themiddnight/xpan-film-camera-3d-print/viewer/src/presentation/content/specifications.md

## Specifications

The numbers below are published from the CAD parameters that also drive the model on this page, so they match what you see. A value marked draft is an estimate until a test print confirms it.

{{spec:specs}}
