themiddnight/xpan-film-camera-3d-print/viewer/src/presentation/content/intro.md

## Build it, or design your own

Everything above comes from the same CAD files that make the printable parts. What follows is for people who want to build the camera or design a body or lens for it. Each figure is live: it is the CAD model, restaged.
