themiddnight/xpan-film-camera-3d-print/docs/images/custom-lens-side-40mm-diameter.jpeg

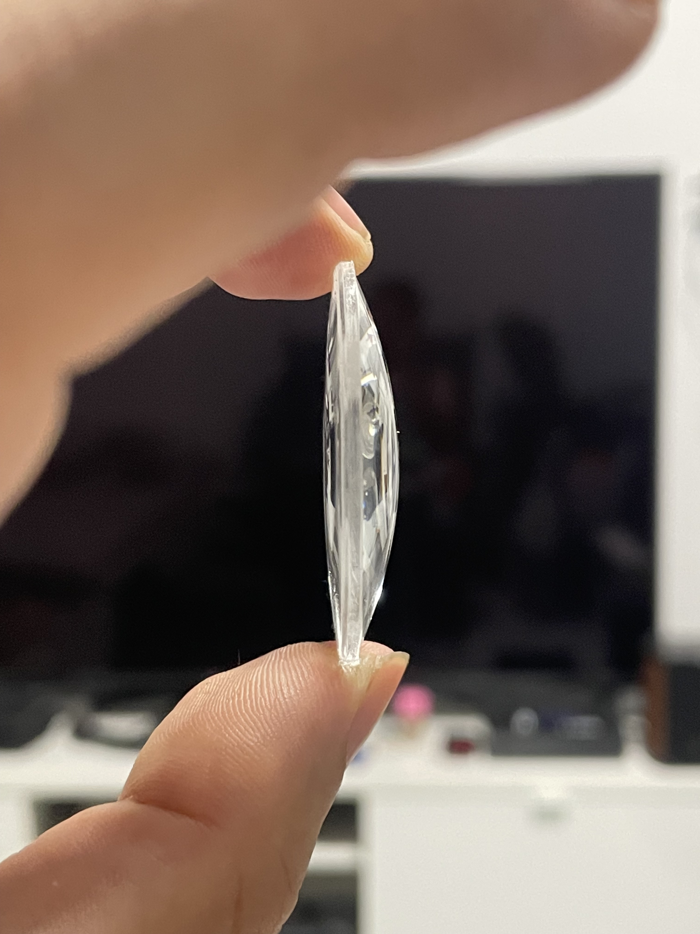
docs/images/custom-lens-side-40mm-diameter.jpeg
