themiddnight/xpan-film-camera-3d-print/docs/images/custom-lens-witn-exist-body.jpeg

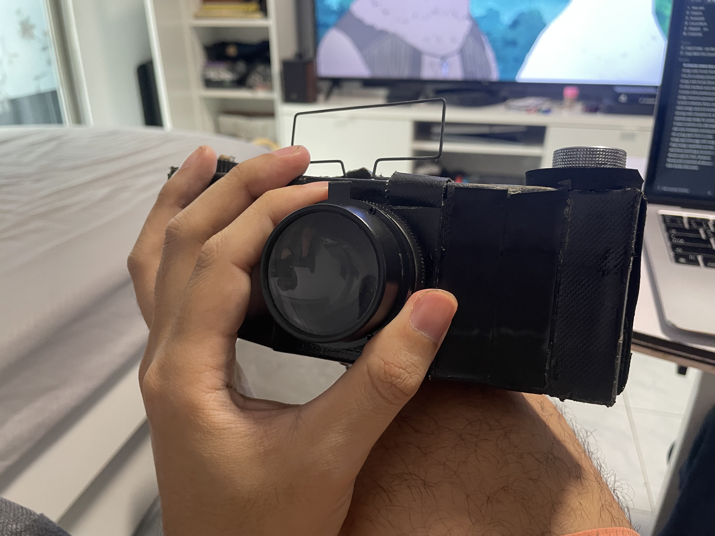
docs/images/custom-lens-witn-exist-body.jpeg
