themiddnight/xpan-film-camera-3d-print/docs/images/example-custom-lens-1.jpeg

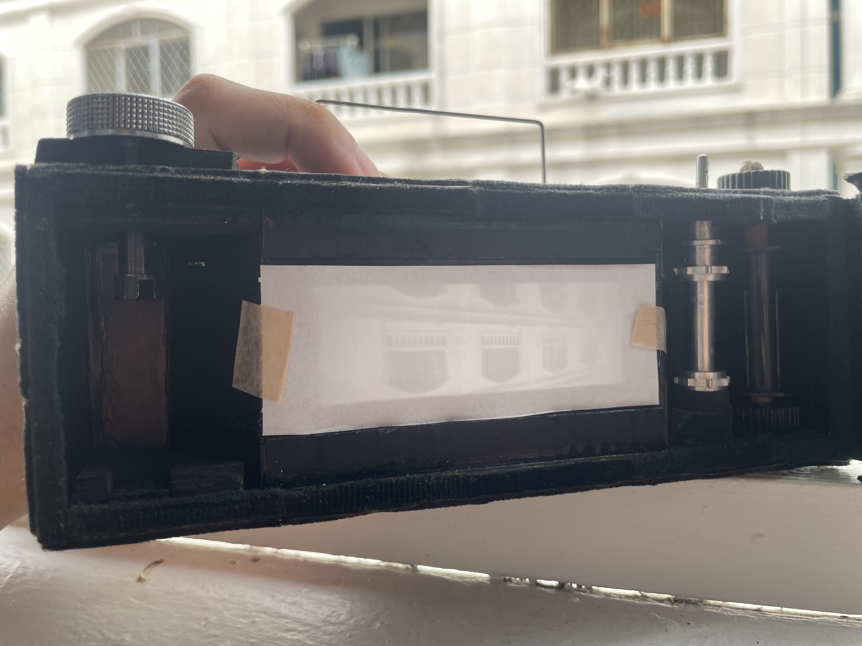
docs/images/example-custom-lens-1.jpeg
