themiddnight/xpan-film-camera-3d-print/docs/images/example-custom-lens-3.jpeg

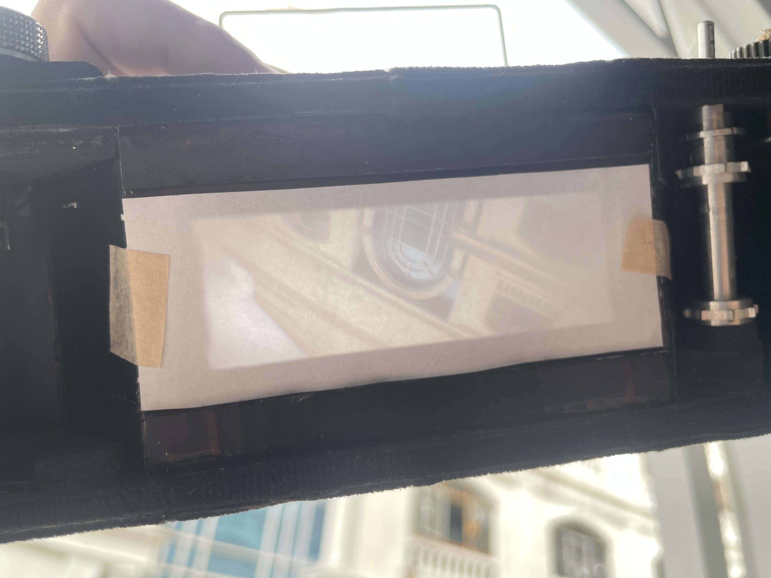
docs/images/example-custom-lens-3.jpeg
