themiddnight/xpan-film-camera-3d-print/docs/images/exist-72x24mm-pinhole-custom-camera-m42.jpeg

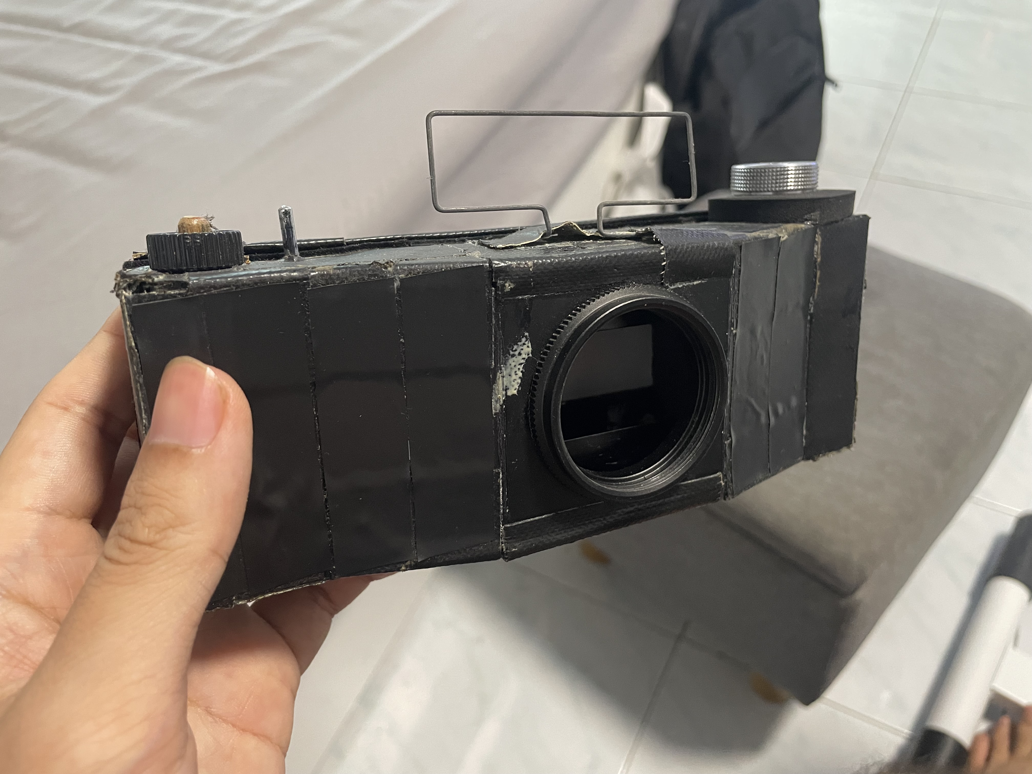
docs/images/exist-72x24mm-pinhole-custom-camera-m42.jpeg
