themiddnight/xpan-film-camera-3d-print/docs/images/exist-m42-pinhole.jpeg

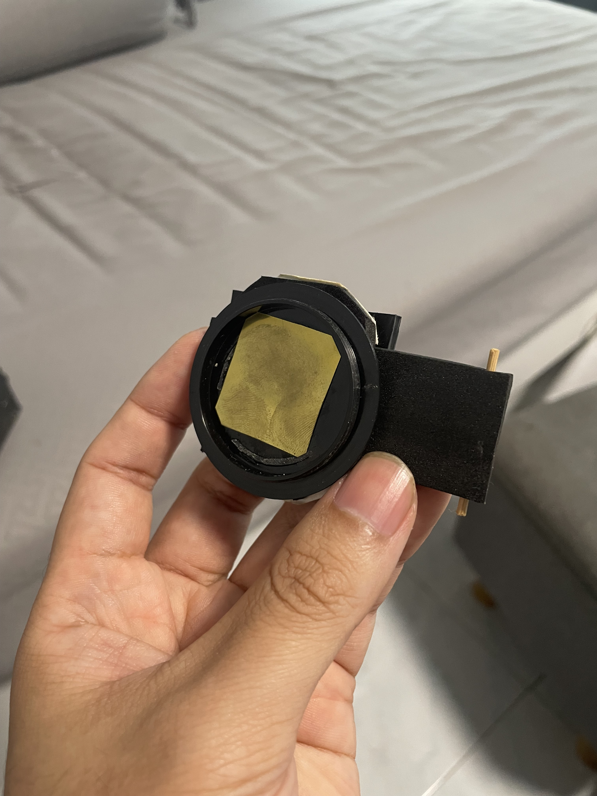
docs/images/exist-m42-pinhole.jpeg
