themiddnight/xpan-film-camera-3d-print/docs/images/proto-film-back-rough-design.png

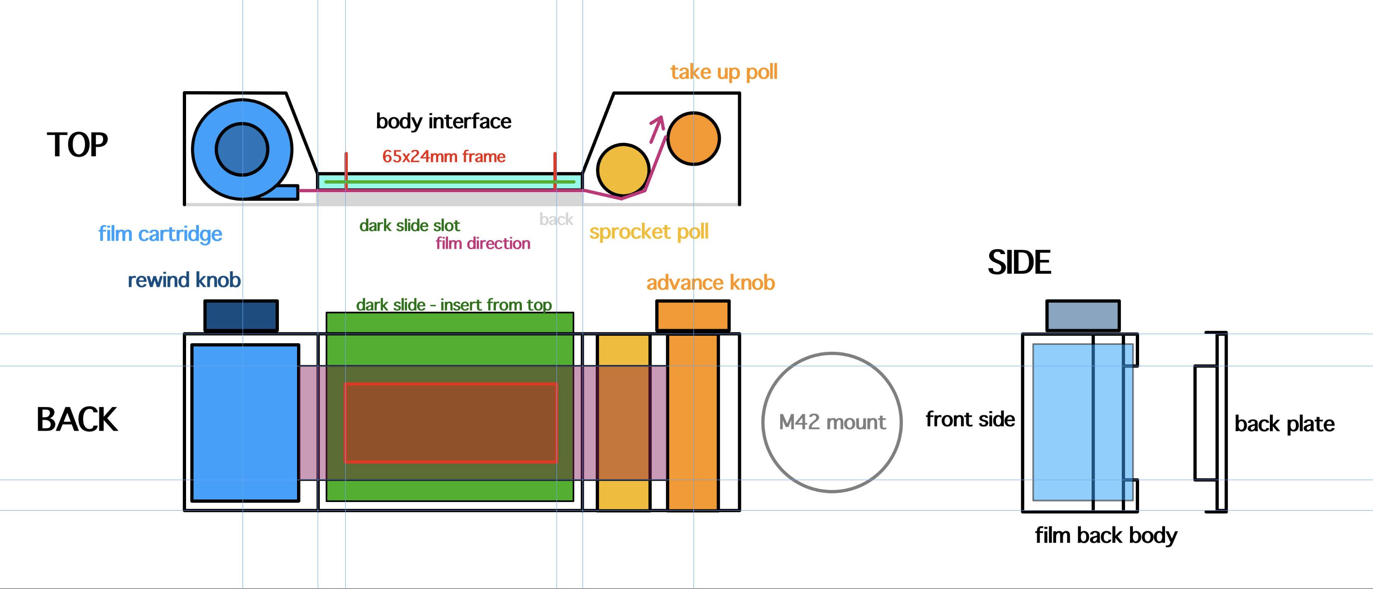
docs/images/proto-film-back-rough-design.png
