themiddnight/xpan-film-camera-3d-print/out/stills/advance.png

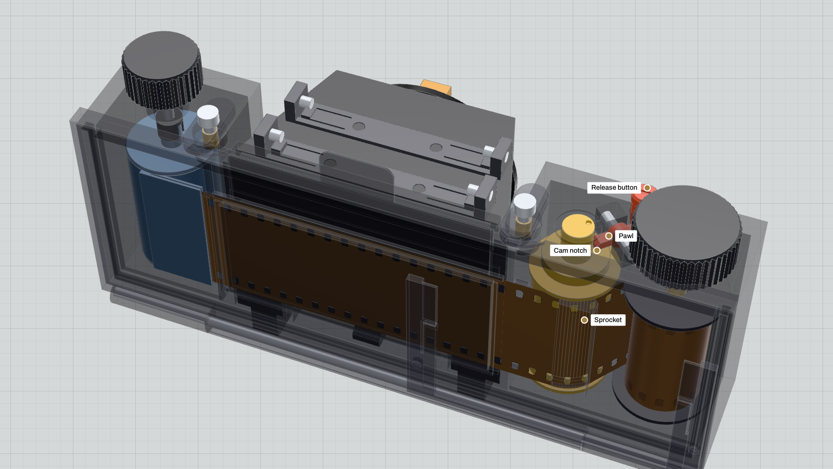
out/stills/advance.png
