themiddnight/xpan-film-camera-3d-print/out/stills/dark-slide.png

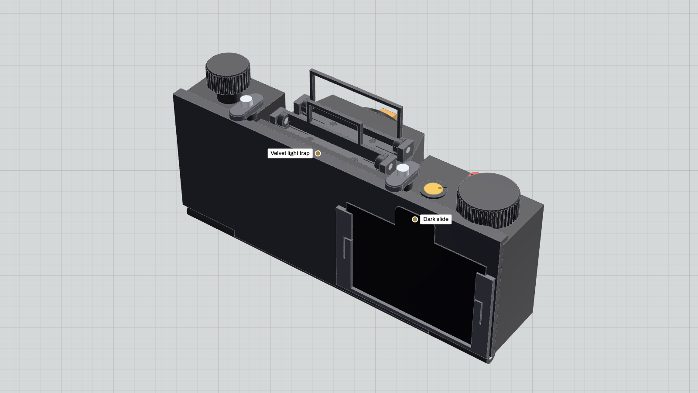
out/stills/dark-slide.png
