themiddnight/xpan-film-camera-3d-print/out/stills/format.png

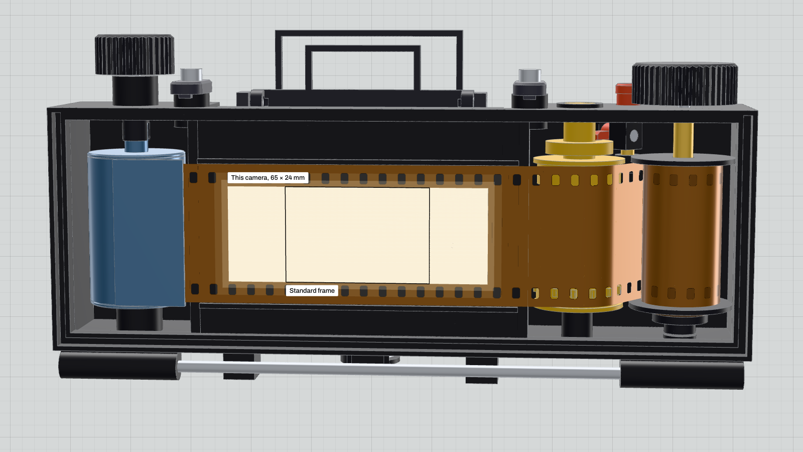
out/stills/format.png
