themiddnight/xpan-film-camera-3d-print/out/stills/loading.png

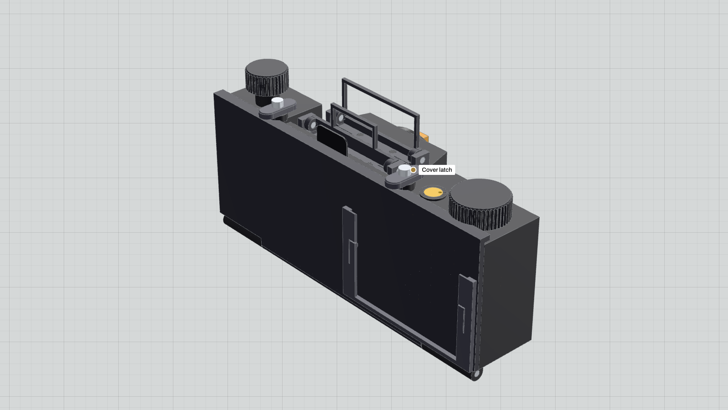
out/stills/loading.png
