themiddnight/xpan-film-camera-3d-print/out/stills/modules.png

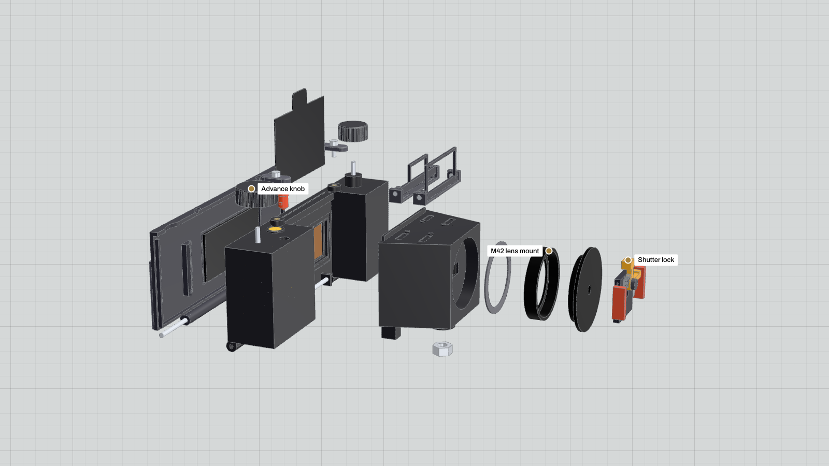
out/stills/modules.png
