themiddnight/xpan-film-camera-3d-print/out/stills/og.png

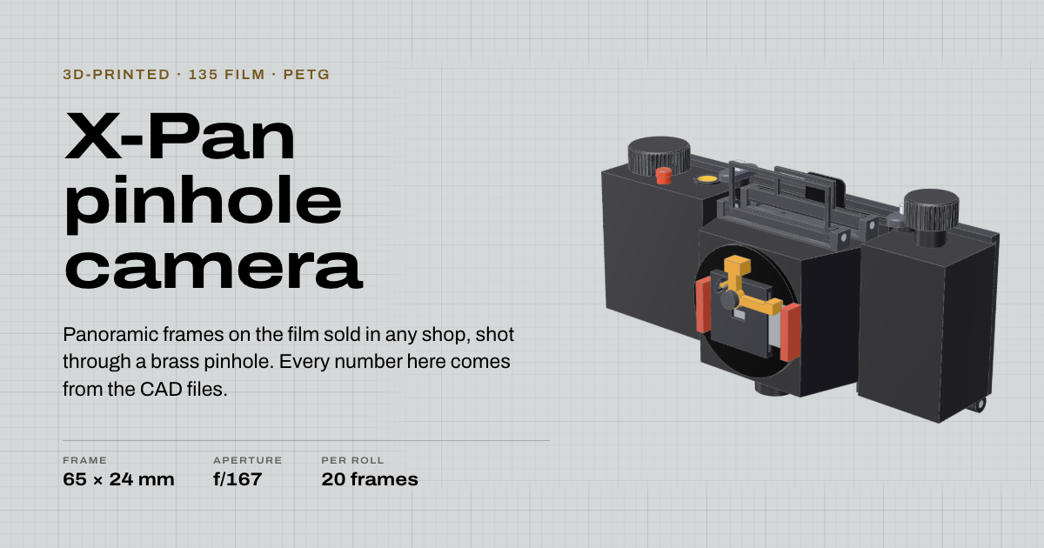
out/stills/og.png
