themiddnight/xpan-film-camera-3d-print/out/stills/shutter.png

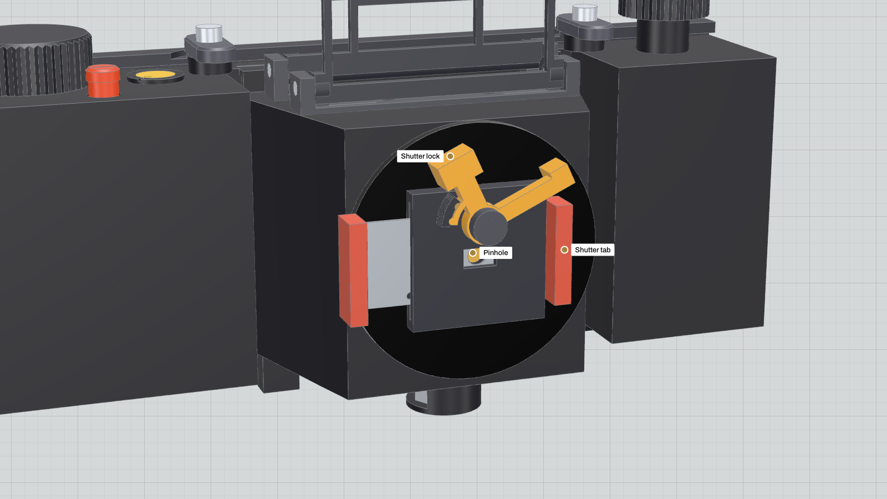
out/stills/shutter.png
