themiddnight/xpan-film-camera-3d-print/out/stills/swap-body.png

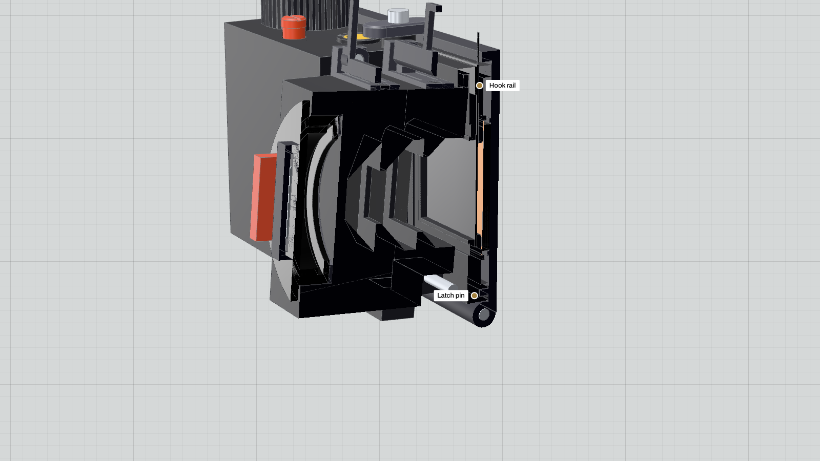
out/stills/swap-body.png
