themiddnight/xpan-film-camera-3d-print/out/stills/viewfinder.png

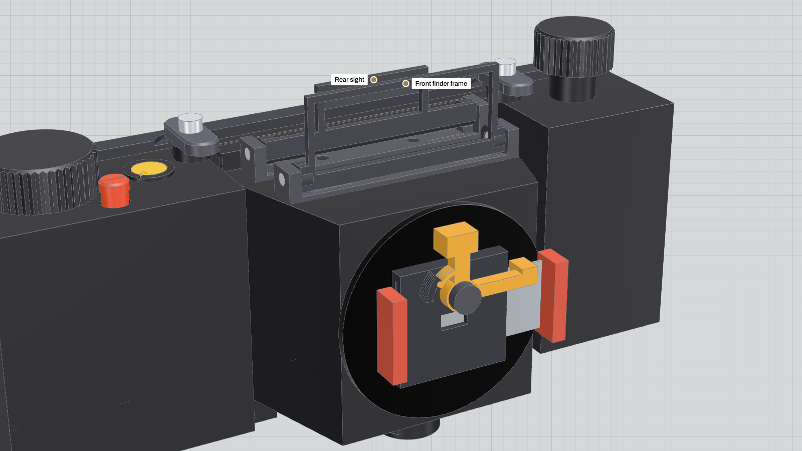
out/stills/viewfinder.png
