themiddnight/xpan-film-camera-3d-print/viewer/src/presentation/content/parts.md

## Parts

Every piece of the camera, by module. Some you print, some you cut from a material in the bill of materials below, and some you buy ready-made. Each size is the piece's longest side. Every part is drawn at the same scale, so the pictures show how big the pieces are next to each other.

{{parts}}
