themiddnight/xpan-film-camera-3d-print/viewer/src/presentation/content/bom.md

## Bill of materials

What to buy for the film back, the simple body and the pinhole module: the ready-made pieces and the materials the stock pieces are cut from. The Parts section above says which piece comes from which row. Everything else is printed in black PETG.

{{bom}}
