themiddnight/xpan-film-camera-3d-print/out/stills/parts/advance_knob.png

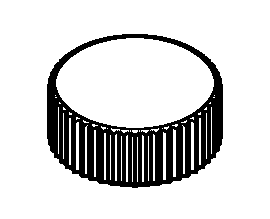
out/stills/parts/advance_knob.png
