themiddnight/xpan-film-camera-3d-print/out/stills/parts/dark_slide.png

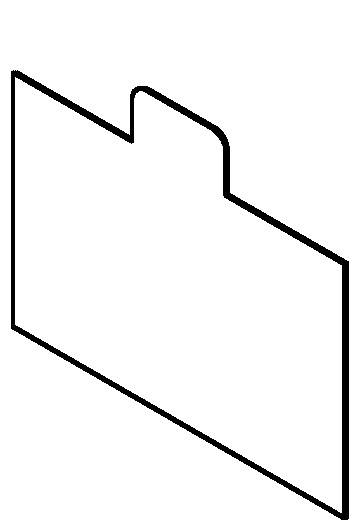
out/stills/parts/dark_slide.png
