themiddnight/xpan-film-camera-3d-print/out/stills/parts/drive_collar.png

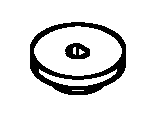
out/stills/parts/drive_collar.png
