themiddnight/xpan-film-camera-3d-print/out/stills/parts/hinge_pin.png

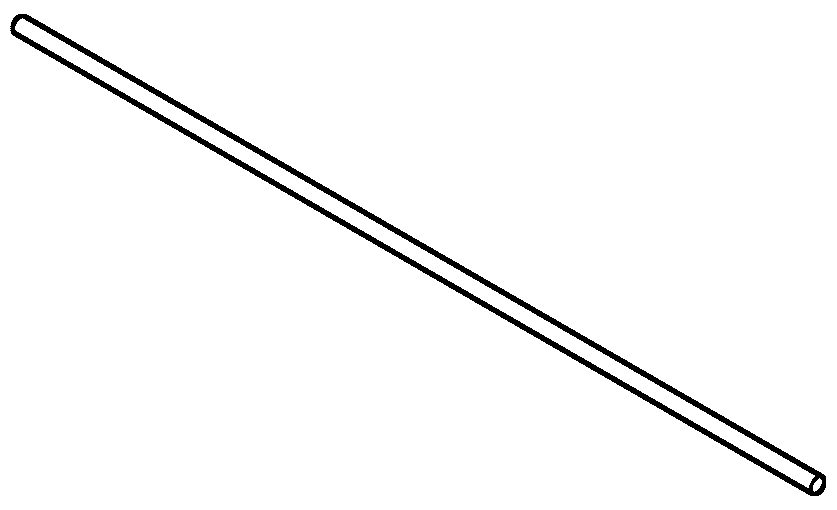
out/stills/parts/hinge_pin.png
