themiddnight/xpan-film-camera-3d-print/out/stills/parts/m42_body_cap.png

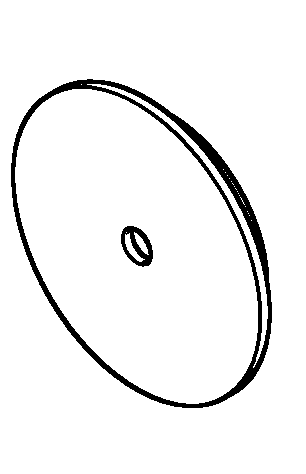
out/stills/parts/m42_body_cap.png
