themiddnight/xpan-film-camera-3d-print/out/stills/parts/m42_shim_ring.png

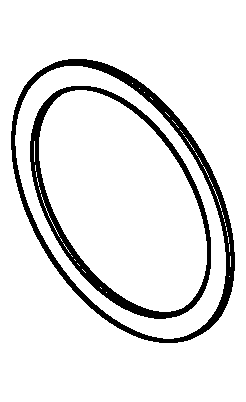
out/stills/parts/m42_shim_ring.png
