themiddnight/xpan-film-camera-3d-print/out/stills/parts/pawl.png

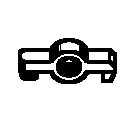
out/stills/parts/pawl.png
