themiddnight/xpan-film-camera-3d-print/out/stills/parts/pinhole_body.png

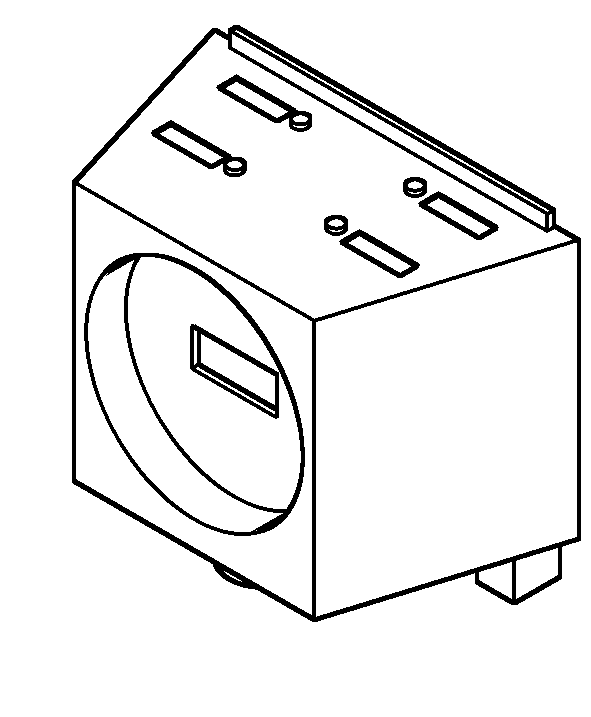
out/stills/parts/pinhole_body.png
