themiddnight/xpan-film-camera-3d-print/out/stills/parts/pressure_pad.png

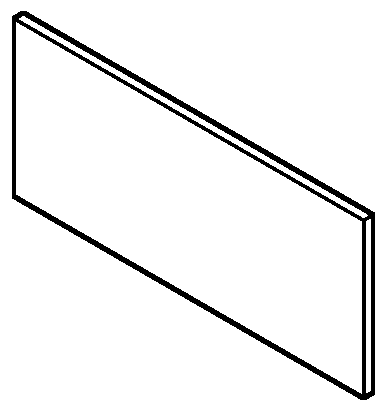
out/stills/parts/pressure_pad.png
