themiddnight/xpan-film-camera-3d-print/out/stills/parts/rear_cover.png

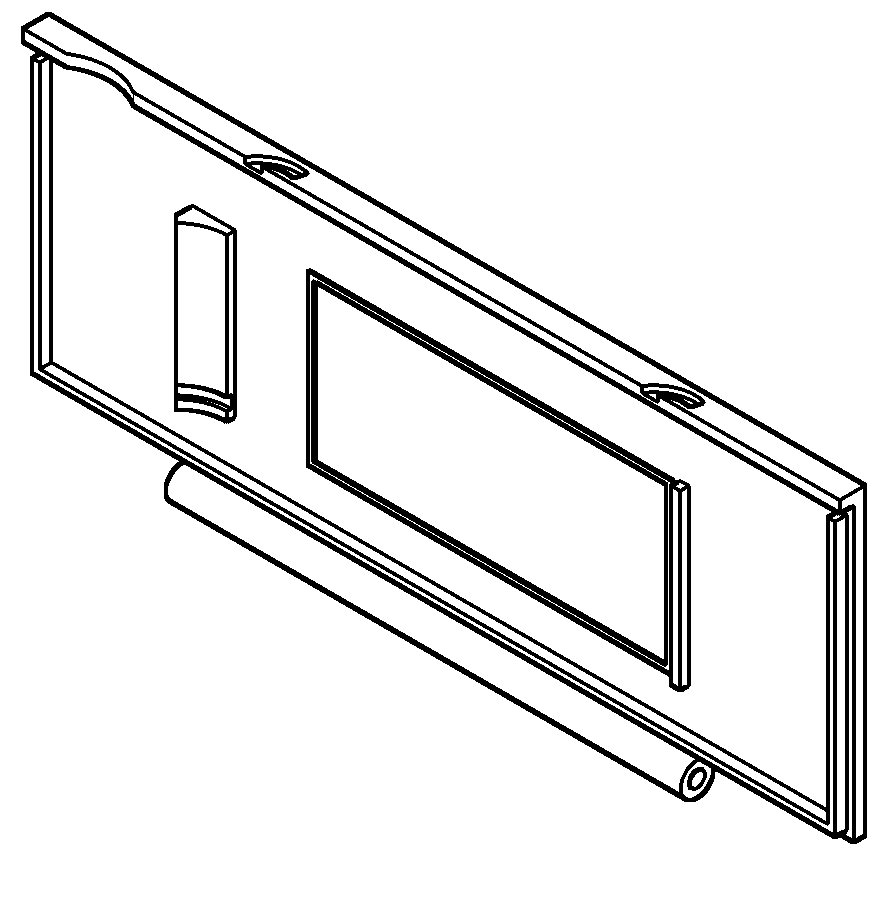
out/stills/parts/rear_cover.png
