themiddnight/xpan-film-camera-3d-print/out/stills/parts/rewind_knob.png

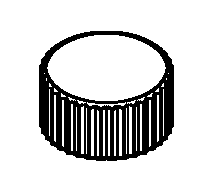
out/stills/parts/rewind_knob.png
