themiddnight/xpan-film-camera-3d-print/out/stills/parts/shell.png

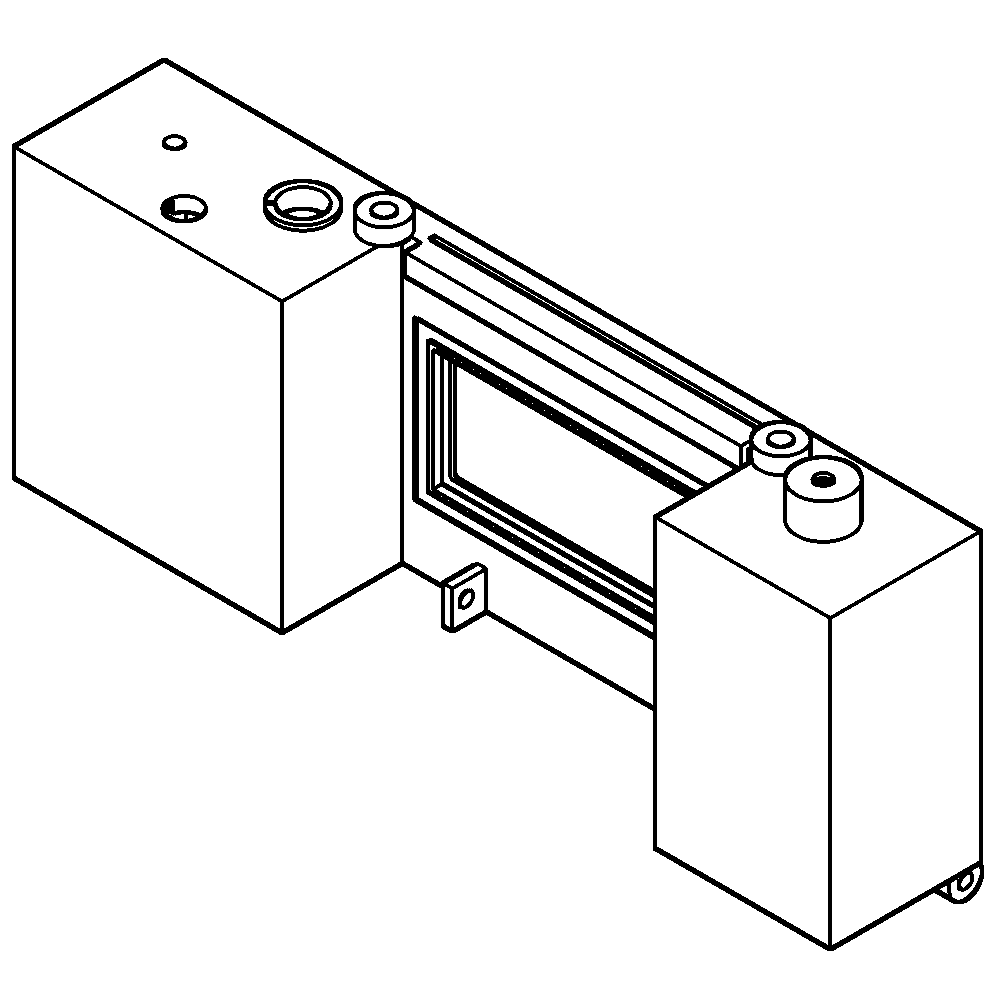
out/stills/parts/shell.png
