themiddnight/xpan-film-camera-3d-print/out/stills/parts/shutter_blade.png

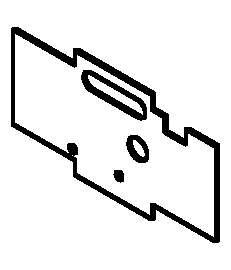
out/stills/parts/shutter_blade.png
