themiddnight/xpan-film-camera-3d-print/out/stills/parts/shutter_housing.png

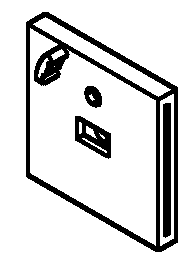
out/stills/parts/shutter_housing.png
