themiddnight/xpan-film-camera-3d-print/out/stills/parts/shutter_lock.png

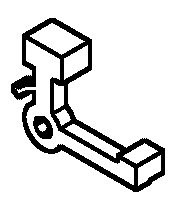
out/stills/parts/shutter_lock.png
