themiddnight/xpan-film-camera-3d-print/out/stills/parts/slide_holder.png

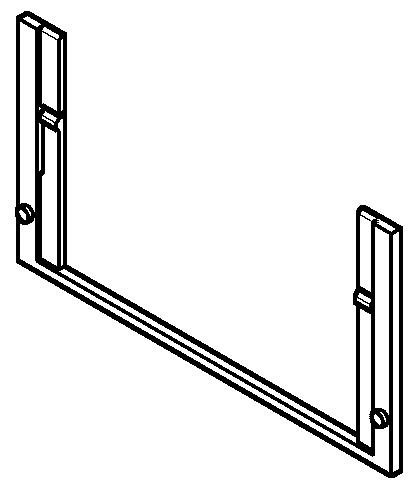
out/stills/parts/slide_holder.png
