themiddnight/xpan-film-camera-3d-print/out/stills/parts/slot_velvet.png

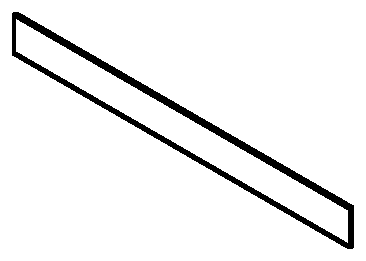
out/stills/parts/slot_velvet.png
