themiddnight/xpan-film-camera-3d-print/out/stills/parts/sprocket.png

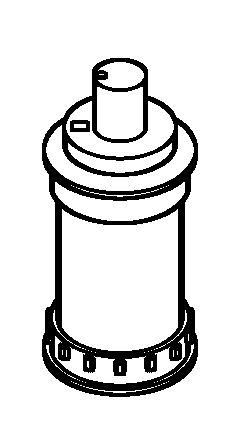
out/stills/parts/sprocket.png
