themiddnight/xpan-film-camera-3d-print/out/stills/parts/takeup_spool.png

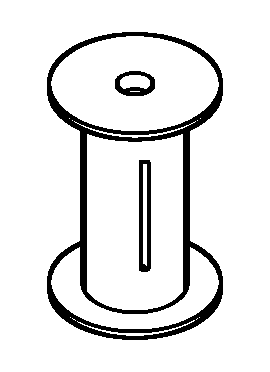
out/stills/parts/takeup_spool.png
