themiddnight/xpan-film-camera-3d-print/out/stills/parts/tripod_nut.png

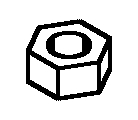
out/stills/parts/tripod_nut.png
