themiddnight/xpan-film-camera-3d-print/out/stills/parts/turn_button_left.png

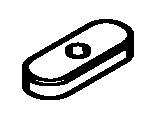
out/stills/parts/turn_button_left.png
