themiddnight/xpan-film-camera-3d-print/out/stills/parts/viewfinder_front_frame.png

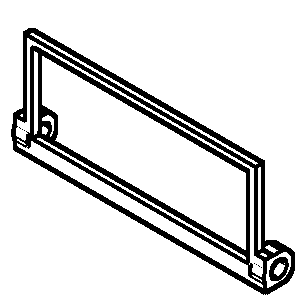
out/stills/parts/viewfinder_front_frame.png
