themiddnight/xpan-film-camera-3d-print/out/stills/parts/viewfinder_rear_frame.png

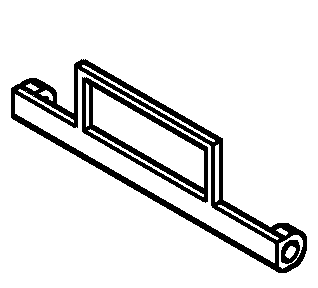
out/stills/parts/viewfinder_rear_frame.png
