themiddnight/xpan-film-camera-3d-print/(list of files, cad)

Other CAD files:
model/film-back-v01.scad
