themiddnight/xpan-film-camera-3d-print/viewer/src/presentation/content/printing.md

## Printing and assembly

### Printing

Coming after the test print.

### Assembly

Coming after the test print.
