themiddnight/xpan-film-camera-3d-print/(commit log)

2026-10-21 Snapshot existing design docs and OpenSCAD models
    [film-back-v01-fixed.scad, film-back-v01.scad, pinhole-module-v01.scad, simple-body-v01.scad]
2026-10-21 Remove unusable OpenSCAD models and make AGENTS.md the single brief
    The v01 models never reached a usable state and OpenSCAD is no longer
    available, so the redesign starts without them. CLAUDE.md now only
    imports AGENTS.md.
    [film-back-v01-fixed.scad, film-back-v01.scad, pinhole-module-v01.scad, simple-body-v01.scad]
2026-10-21 Add redesign roadmap for the first working pinhole camera
2026-10-21 Phase 1: design review, single modeling values and BOM
    Review the film back, simple body and pinhole module against film
    standards (SMPTE ST 139 perforations) and fix errors found:
    - film advance is exactly 66.5mm; about 19-20 frames per 36-exp roll
    - sprocket hub 21.04mm (pitch minus film thickness), S-path wrap of
    49-63 deg with a cover-mounted shoe; rails moved to the edge band
    - sprocket and cam as one part with a face notch and lever pawl
    - felt clutch on the take-up, gate-only pressure pad with a drag limit
    - quarter-turn release hold for rewind, rewind tower for the fork lift
    - M42 mount from bought caps, tripod nut in the body, slot plug
    Add single-value modeling tables (film_back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
2026-10-21 Phase 2: build123d tooling, checks and three.js viewer
    - cad/params.py: every dimension in one Camera object; Fit holds
    printer-dependent values, Measured holds values to confirm on parts
    - cad/parts: registry plus the sprocket and cam as the trial part
    - cad/export.py: STL (print orientation, on Z=0), STEP and GLB (camera
    coordinates) and a manifest for the viewer
    - cad/checks.py: layout checks from params and geometry checks that
    probe the built solid (tooth count, advance per turn, tooth size,
    notch pocket, notch under the pawl in the assembled pose)
    - cad/test_checks.py: 15 seeded design errors, each caught
    - viewer/index.html: part toggles, ghosting, section planes, exploded
    v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
2026-10-21 Move documents under docs/ and tests under cad/tests
    - design docs to docs/design/ (camera, film-back, simple-body, lens)
    - research to docs/research/, images and the sketch to docs/images/
    - bom.md to docs/, seeded-error tests to cad/tests/
    - remove pinhole_design.md, which only pointed at other files
    - rewrite links and path mentions; AGENTS.md gains a layout table
2026-10-21 Port the viewer to Vite + React + react-three-fiber
    Replace the single-file three.js viewer with a Vite + React + R3F app
    under viewer/, reading out/manifest.json and out/glb/ as before.
    Features match the old viewer: part toggles and ghosting, section
    planes with a dark cut face, exploded view, sprocket rotation with
    film advance readout, and named views.
    - Each part loads inside its own error boundary, so a missing GLB is
    reported in the HUD instead of blanking the page.
    - flat rendering (no tone mapping), as in the old viewer.
    - Transparent canvas, so the theme background comes from CSS only.
    - Materials are disposed and bounds cleared when a part unmounts.
    - The spin readout re-render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
2026-10-21 Add film transport anatomy figure
    An isometric explainer of the right-hand film transport: film wrapping
    the 14-tooth sprocket, the one-pocket cam and pawl lock, the release
    button and the take-up spool with its felt clutch. model.mjs holds the
    truth from film-back.md; pose.mjs draws the moving parts for the build
    and the page; build.mjs writes dark and light standalone pages.
2026-10-21 Scaffold phase 3-4: per-area registries, mechanisms and check areas
    Split the part registry, checks and seeded tests by area so parts can
    be modeled in parallel without shared edits. Add mechanisms.py and the
    new manifest fields (group, kind, mechanisms) that replace the sprocket
    spin flag. Plan in docs/superpowers/specs/2026-10-22-phase3-4-parts.md.
2026-10-21 Add assembly checks: print bed for every printed part, interference between all parts
2026-10-21 viewer: manifest mechanisms, grouped parts panel, layered explode
    Parse the manifest once at the boundary into typed groups, kinds and mechanisms, with a
    clear error for a bad one. Each mechanism gets a 0-1 slider, play/pause and readout; values
    live outside React and one useFrame composes every part's drives and explode offset.
    Parts panel is grouped and collapsible with group visible/ghost and a printed/bought filter.
    Explode steps groups along Y and spreads parts from their group centre. State moves to a
    small store with selectors, and PartModel is memoised so drags render no part.
2026-10-21 viewer: scripted cycles (one frame advance), cyclic mechanisms, focus cutaway
2026-10-21 film: cassette and film strip reference solids with checks and seeds
    Cassette in its chamber (shell, caps, key end, stub, felt-lip block) and the loaded
    strip along the S path with both KS perforation rows phased onto the sprocket teeth.
    Six geometry checks (rails, run length, hub contact, tooth centring, flanges,
    chamber fit) each with a seeded error.
2026-10-21 body: model the 50mm body, M42 stack, viewfinder and pinhole shutter with checks
    Body with baffles, M42 pocket, top tongue, rear latch hook, tripod nut boss
    and hinge-block pockets; shim ring, hinge blocks, rear cap ring, nut and wire
    finder; pinhole module with body cap, shim, shutter housing, blade and lock
    pin. Ten geometry checks with twelve seeded errors.
2026-10-21 docs: body latch hook sits behind the pin, as modeled
2026-10-21 transport: pawl, release button, take-up clutch stack, rewind fork and knobs, bought rods and springs
2026-10-21 Mechanisms and the frame-advance cycle from the design values; lock and ride checks
    Advance is cyclic (sprocket and take-up turn on), release presses the button
    and lifts the pawl, the pawl rides the cam between clicks. The frame cycle
    follows film-back.md 8.2. Docs: rewind shaft 21mm, take-up shaft span.
2026-10-21 shell: film-back shell, rear cover, turn buttons, slot plug and their bought parts
    Shell with gate, rails, fences, dark slide slot, datum face and velvet groove,
    cassette and take-up chambers, sprocket and take-up bushings, rewind tower, pawl
    cheeks, spring shelf, release button bayonet, rear rim with seal groove, body
    hook and latch lugs, turn-button insert bosses and two end hinge knuckles.
    Cover with tongue, top lap, pad rim, throat land, sprocket shoe and middle
    knuckle. Fourteen geometry checks with seeded errors.
2026-10-21 Integrate phase 3-4: cover, latch and dark slide mechanisms, moving film strip, mechanism view
    - Interference check compares every pair (BoundBox.overlaps skipped contained boxes)
    and allows only named fits up to a volume limit.
    - Cassette spool end carries a key blade for the rewind fork.
    - Film exported as its path; the viewer draws it with scrolling perforations
    so the strip moves with the advance. The wound roll is its own part.
    - Show mechanism ghosts the covers and frames the moving parts from the rear right.
    - Press-fit hole moved to Fit.
2026-10-21 Review fixes: cycle check, fit ranges, seeds, stale exports, viewer focus and film strip
    - Pocket clearance measured at the nose's innermost radius; the cycle check
    reads where the button starts up and no longer crashes on a missing key.
    - Intended overlaps have a least and a most volume, so a press fit that stops
    gripping fails. Seeds for the bed, loose pins and a spool clash.
    - export.py removes files of parts no longer registered.
    - Viewer: Show mechanism restores the user's part views; ghosted film stays
    visible; the strip's texture and geometry are disposed; cycles start from
    the last whole frame; internal mechanisms get no slider.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
2026-10-21 transport: arc the pawl nose face about the pivot so it clears the pocket wall; sweep check
    The square nose's lower corner swung into the cam pocket wall at 8-14 deg of lever turn
    (0.07mm3). The face toward the sprocket axis is now an arc about the pivot axis. The nose
    check sweeps the release (0 to lift) and the drop (ride to 0) at 0.5 deg.
2026-10-21 body: stand the camera on three feet below the hinge knuckles, nut moved into the boss
    The rear-cover hinge knuckles hang 7.3mm under the film back, so the old 0.5mm tripod
    boss left the camera tipping 11 degrees on a table and a tripod plate hitting the
    knuckles. The tripod boss and two rear pads now end in one plane 0.75mm under the
    lowest knuckle (derived from the cover hinge params), the nut sits in the boss with
    1.2mm of floor so a 5mm screw engages 3.8mm, and the checks prove the seat is the
    lowest plane, the camera stands level with its centre of mass over the feet, and the
    screw reaches the nut.
2026-10-21 shell: latch dog and lip groove so the turn buttons hold the cover shut
    The hinge is 68mm under the lip, so opening slides the lip straight back
    out from under a flat button. Each button now carries a dog under its rear
    end that sits in an arc groove in the (now 2.5mm) lip; opening drives the
    groove's front wall into the dog. The groove follows the dog's quarter
    turn out past the lip's front edge, so the released button clears the
    cover's swing. Buttons print top down.
    Checks: latched buttons stop the opening cover; the quarter turn is clear
    of every part round it; the cover swing now includes the released
    buttons. Seeds for each. The shell build cache keys on the whole Camera
    and the per-a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
2026-10-21 Mechanism sweeps, prerequisites and a compressing pawl spring
    - Every mechanism is swept through its range, and the frame cycle through
    its keys, against every part; allowed motion overlaps are named per mechanism.
    - Mechanisms carry prerequisites (cover needs the latches turned, advance
    lifts the pawl onto the cam, shutter needs its lock released).
    - New stretch drive: the pawl spring shortens as the lever presses it.
2026-10-21 transport: hemispherical nose on the release button so it drives the turning pawl lever at one point; press sweep check
2026-10-21 pinhole: captive shutter lock lever, slider knob and travel stops
    Replace the removable shutter lock pin with a lock lever that pivots on a
    pressed 3mm rod. Its tooth drops into a notch in a new ridged slider knob
    glued to the blade. The blade's stadium slot around the pivot gives end
    stops at closed and at 10mm open. An arc spring finger clicks the lever
    into place locked and unlocked. Shutter checks and seeds move from the
    body area to new pinhole files.
2026-10-21 Shutter lock and slide mechanisms, pivot press fits, spring follow allowance
2026-10-22 body: two-frame folding sports finder replaces the wire finder
    The rear (eyepiece) and front windows are printed leaves with the 65:24
    shape, sized so they line up from one eye point 9.3mm behind the rear
    cover and frame the 65x24 field at 50mm. Nothing reaches behind the
    body's rear face. Each leaf turns on two pressed 3mm pin stubs in a
    glued hinge base whose sprung tongue clicks it raised and folded. Both
    fold forward: front first, rear on top, 9.4mm over the body top.
    Checks measure the field on the built windows, the sight lines, the
    folded outline and height, the fold sweep and the detents, each with a
    seed. Two mechanisms fold the frames in the viewer; the rear needs the
    front folded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
2026-10-22 spec: two-frame finder parts and its fold mechanisms
2026-10-22 body: front frame with an optional rear sight, eye at the rear cover
    The finder now frames with the camera held against the face: the eye
    point is the rear cover's outer face. The front frame stands at Y 28,
    as far forward as its knuckles stay out of the field and its hinge fits
    the tapering body top. A small 65:24 rear sight centres the eye when
    raised and stays out of the field when folded. The sight folds forward
    under the raised frame; the frame folds back over it. Knuckles grow to
    6.4mm so the detent flats keep min_wall over the bore, and the sight-line
    check now also covers the field beyond the front window.
    Adds a body_detach mechanism: the body tilts 5 deg about its tongue in
    the fi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
2026-10-22 pinhole: push-only shutter with two tabs and the lock on top
    The blade now ends in a push tab on each side of the housing: push the
    -X tab in to open, the +X tab in to close. At each end of the travel the
    tab to push next stands 14mm past its housing edge and the other 4mm, so
    the state reads by feel. The slider knob is gone.
    The lock lever moves to the top of the housing. It pivots on the stop
    pin 7.5mm above the pinhole; its tooth drops into a notch in the -X
    tongue's top edge, level with the pivot, so a push on the tab loads the
    tooth through the pivot. The notch is outside the housing only while the
    shutter is closed, so the lever cannot lock it open. The thumb pad
    stands above the hous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
2026-10-22 film back: dark slide pinch tab and a holder on the rear cover
    Replace the 40mm carry handle (28mm over the plate, 24 x 8mm finger hole)
    with a 20mm pull tab whose top sits 8mm over the cover lip. Add a printed
    slide_holder, glued to the cover's outer face right of the eye line: two
    side rails over a stop bar, a sprung finger with a bump in each rail
    pressing the slide onto the cover. Two new mechanisms, slide_carry
    (internal) and slide_stow, put the slide in the holder in the viewer.
    Checks and seeds cover the grip, the fit and hold, and clearance closed,
    swung open, over the tripod seat and off the face rest.
2026-10-22 film back: velvet light trap in the slot mouth replaces the slot plug
    The slot plug sat in the slot mouth at rest, on top of the dark slide,
    so the model showed both in the same slot. The mouth now closes itself:
    its top 7mm widens forward to 1.2mm and a foam-backed velvet strip on
    the front face presses onto the rear face once the slide is out, the
    way a 135 cassette's plush lips seal its slot. Only the front side
    widens because the rear face is the 1.2mm gate plate. A new check
    proves the pile meets the rear face, the slide leaves it above its
    crushed limit, the pocket walls hold min_wall and the pocket stops
    above the gate, with three seeds.
    Mechanism posing moves into checklib (posed, S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
2026-10-22 pinhole body: rename the body part and its files to pinhole_body
    A lens body with a shutter will join the body group later, so the
    pinhole body's part name, export files and modules name it explicitly.
    The body group itself stays.
2026-10-24 cad: feature anchors and spec sheet in the manifest
    features.py lists 20 pins (part plus an anchor computed from params and the part's placement);
    spec_sheet.py publishes 32 labelled values with unit, section and status. export.py writes both
    to manifest.json. Checks prove each anchor lies on its part's surface, ids are unique and real,
    sources resolve and derived values match their formulas; nine seeds cover them. test_checks.py
    lets a seed carry a patch for errors that are not Camera values. Optics gains m42_pitch.
2026-10-24 viewer: presentation and workshop entries, story validator
    index.html is now the presentation entry (a placeholder until the showcase
    lands) and workshop.html is the existing viewer, with its UI under
    src/workshop/. The manifest parser reads the features and spec_sheet blocks
    strictly. validateStory checks every part, group, mechanism, cycle and
    feature a chapter or figure names against the manifest.
    build:public builds the presentation alone, copies only the manifest, GLBs
    and stills from out/, and check-public.mjs fails on the workshop page,
    workshop code or any STL/STEP file.
2026-10-24 checks: seeds run only the checks they must trip, in parallel
    A seed is caught or missed on its expected checks alone, so the runner no
    longer runs all 124 checks per seed. Shipped checks and seeds run as
    separate tasks across every core. Measured on 8 cores: a full check run
    takes 229.5s, so the old suite needed about 8.9h for 131 seeds; the new
    one finishes in 7 min with all 131 seeds caught and every shipped check
    passing. The per-seed list of collateral failures is no longer printed.
2026-10-24 viewer: staged views on a shared canvas
    The presentation draws every staged view into one fixed canvas split by
    drei View, each with its own viewer so mechanisms move independently.
    PartsScene is extracted from the workshop Viewport and shared by both.
    - applyStaging and shotFor set a viewer's scene and fit a camera to the
    framed parts at the view's aspect; ShotRig eases there over 0.8 s and
    cuts under reduced motion.
    - Pins hang under part nodes, so they ride with mechanisms, and hide
    when their part is hidden or failed to load.
    - The canvas renders on demand; MotionDriver requests frames while a
    cycle or mechanism moves, and stops when idle.
    - Part GLBs load once per page through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
2026-10-24 viewer: presentation showcase
    The public page now tells the camera's story in nine scroll-driven
    chapters on one 3D stage: hero, format, modules, frame advance, loading,
    dark slide, shutter, viewfinder and swapping the body. Each chapter is
    data in chapters.ts, validated against the manifest, and every number
    in its copy comes from the CAD spec sheet.
    - Showcase restages one StagedView per chapter; a Director inside the
    view stops every chapter's motion on a change and autoplays the new
    one once the camera has arrived (not under reduced motion).
    - KeyPlayer (extracted from CyclePlayer) plays inline keys too, with
    pause, seek, restart and stop for the playback bar.
    - The film-strip nav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
2026-10-24 cad: standard frame width and frames per roll in the spec sheet
    The spec sheet gains standard_frame_width (locked, from the new Film.standard_frame_w)
    and frames_per_roll (derived, rounded down to whole frames, draft until a test print
    measures the loading waste). Film.frames_per_roll holds the one formula, which the
    checks' INFO line now reuses. FormatOverlay reads the standard width from the spec
    sheet instead of a constant, and the format chapter says how many frames a roll holds.
    A seed rounds frames_per_roll up to prove the derived check catches it.
2026-10-25 viewer: staged overlays turn with the parts, so the format frame stays on the gate
2026-10-25 viewer: phone shots framed above the active card; a chapter's first pose survives the staging reset
2026-10-25 viewer: graph paper behind the camera in every chapter and in stills
2026-10-25 viewer: the modules camera pulls back as the page scrolls, with no settle after it stops
2026-10-25 viewer: page metadata and a 1200x630 share card
    The page had a title, a description and an og:title, but no absolute URL, no
    canonical, no Twitter card and no image sized for a share sheet. It now carries
    the full set, with `%SITE_URL%` filled at build time from SITE_URL so the same
    file works on a local server and on the deploy.
    The share image is a new dev-only page, og.html, that scripts/stills.mjs captures
    into out/stills/og.png beside the chapter stills. Its numbers come from the spec
    sheet, and its paper grid is aligned to the grid in the camera render so the two
    line up.
2026-10-25 repo: README, licence, and the site data the deploy builds from
    The project had no README and no licence, and the site could not be built
    anywhere but on this machine: the public build needs the manifest, the GLBs and
    the stills, which were gitignored with the rest of out/.
    That generated site data is now committed (out/manifest.json, out/glb,
    out/stills) and STL and STEP stay ignored. vercel.json builds
    `pnpm --dir viewer build:public` from it, so a push to main publishes the site
    without running the CAD pipeline on the build machine.
2026-10-26 cad: PartSpec kind stock, bom row, count and inventory flag, written to the manifest
    Stock parts are cut or trimmed from a BOM material; bought parts are ready-made.
    The spec rejects an inventory part that is not printed and has no BOM row.
2026-10-26 viewer: stock kind, part inventory fields and the inventory model
    inventory(manifest) groups the camera's parts by module and then by how a
    builder gets them, merging left/right pairs. BomRow carries the # column.
2026-10-26 viewer: Parts section before the bill of materials, with BOM row anchors
    {{parts}} mounts PartsInventory from content/parts.md. Each BOM row has
    id=bom-<#> so a card can link to the row it comes from.
2026-10-26 viewer: part thumbnails through ?part=, drawn by pnpm stills, checked by verify
    ?part=<manifest name> frames one part alone from one fixed direction
    through the still pipeline. pnpm stills writes out/stills/parts/<name>.png
    for every inventory part. verify checks each thumbnail ships, the Parts
    images load and every BOM link lands on a row.
2026-10-26 cad: one viewfinder pin stub per part, drop PartSpec count
    Each viewfinder pins solid held two 6mm stubs far apart, so its Parts card
    read 63 mm. Register viewfinder_<which>_pin_left and _pin_right instead; the
    viewer's left/right merge shows "Viewfinder rear pin x2" at 6 mm. No part
    needs more than one piece per solid now, so count is removed from PartSpec,
    the export, the manifest types and parser, and the design spec. The inventory
    counts members. The hinge overlap limits are halved to 1.0-2.0 mm3 per stub
    (1.39 mm3 measured). Regenerated out/ with the four new GLBs and thumbnails.
2026-10-26 viewer: Parts tally reads "30 pieces · 13 print · 10 make · 7 buy"
    The module tally printed the raw kind names ("13 printed, 10 stock, 7 bought").
    It now gives the total first, then each kind that has pieces, with a short
    word from KIND_TALLY beside KIND_HEADINGS. The tally function is exported and
    tested against the real manifest.
2026-10-26 cad: manifest gives each part's size where it sits in the camera
    size_mm is the part as built, before placement, so a part placed at an angle
    (the pawl) is larger in the camera than size_mm says. placed_size_mm is the
    bounding box of the placed solid along the camera axes, which is what a
    drawing of the part as assembled has to be sized from.
2026-10-26 viewer: part drawings at true scale from one ?drawings page load
    Each inventory part is drawn as a black-ink line drawing in a true isometric view,
    every part at the same scale (PX_PER_MM), so the shell and a pin show their real size
    against each other. partDrawing.ts owns the view, scale and drawingSize(), which gives
    a drawing's CSS size from the manifest alone. The renderer is a separate module loaded
    by a dynamic import on the ?drawings route, so the public bundle does not carry it, and
    it throws if a model's real bounding box projects to another size than placed_size_mm.
    Replaces the ?part= single-part still, partStill and THUMBNAIL_DIRECTION. pnpm stills
    loads the route once, writes o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
2026-10-26 viewer: Parts section shows line drawings in a wrapping row, no cards
    Each kind is a flex row with align-items flex-end, so drawings stand on a shared
    baseline with the name, count, size and BOM link under each. Images take their
    width and height from drawingSize, so the page lays out before they load. Kind
    headings are sentence case, and the tally reads "30 pieces: 13 printed, 10 made
    from stock, 7 bought". The section intro says every part is drawn at one scale.
